Arduino-STM32-Dev/Arduino-Intro/Image_and_video/Buzzer_sound.jpg

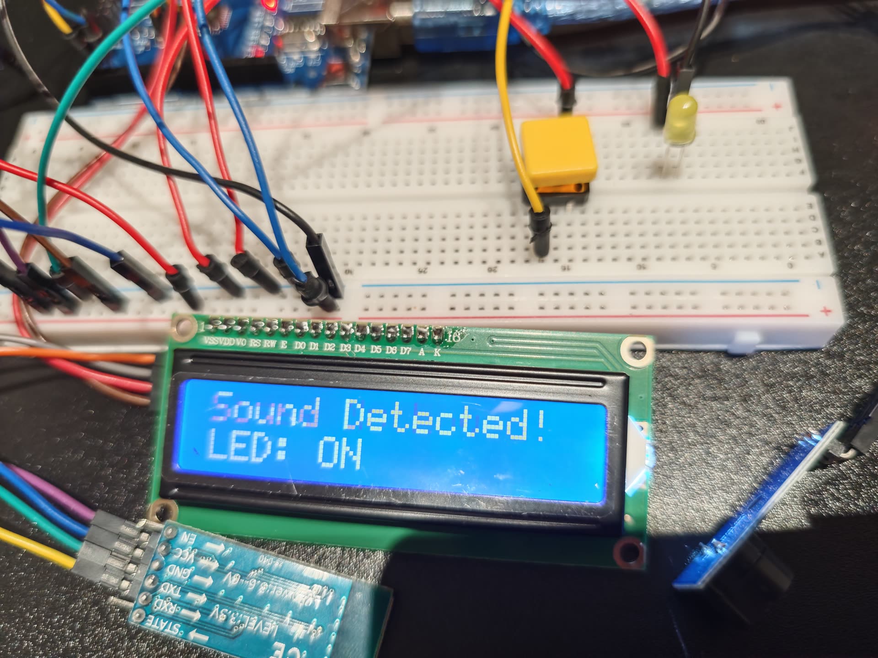
Image_and_video/Buzzer_sound.jpg
