Arduino-STM32-Dev/Arduino-Intro/(commit log)

2026-09-28 docs: 完整项目文档、接线指南与踩坑记录
    - README.md：项目简介、核心功能、硬件清单、引脚接线表、
    手机蓝牙指令表、软件架构解析、调试踩坑记录、未来计划
    - docs/WIRING.md：接线详解、I2C 地址扫描、面包板布局、上电自检清单
    - docs/COMMANDS.md：蓝牙指令协议完整参考与扩展建议
    - docs/TROUBLESHOOTING.md：11 类真实踩坑的现象/原因/解决/原理
    - docs/ROADMAP.md：五个学习阶段的能力跃迁记录
    - docs/LIBRARIES.md：依赖库版本、API 与许可证说明
    - LICENSE (MIT)、.gitignore、.gitattributes
2026-09-28 refactor: 统一目录结构，5 个 sketch 全部归入 firmware/
    按学习顺序排列：
    led_running_on_off -> 阶段1 外部 LED 闪烁 + 串口打印
    screen_words -> 阶段2 LCD1602 并行接线（含损坏行，见 TROUBLESHOOTING #11）
    LCD_show_words -> 阶段3 升级为 I2C 接线
    use_button_control_led -> 阶段4 按键 + 蓝牙控灯
    temp_monitor -> 阶段5 最终完整版（含 DHT11 温湿度）
    Git 识别为纯重命名（内容未改动），历史完整保留。
2026-09-28 docs: 修正内部锚点与相对路径链接
    - GitHub 锚点生成会剥离下划线，screen_words -> screenwords，
    修正 TROUBLESHOOTING 目录与 ROADMAP 的交叉引用
    - LIBRARIES.md 中两个 license 链接补上 ../libraries/ 前缀
2026-09-29 feat: complete integration of bluetooth, DHT11, light, sound and buzzer
    新增两个 sketch，完成从环境光控制到声光反馈的系统级集成：
    - firmware/Intelligent_LED/ 光敏模块(D4)接入，环境过暗自动开灯、变亮自动关灯
    - firmware/Buzzer_module/ (最终完整版) 光敏(D4) + 声音(D5) + 蜂鸣器(D3)
    + DHT11(D7) + 双 LED(D8/D9) + 蓝牙 + LCD + 按键
    - 补全 DHT11 温湿度查询（T 指令），使最终固件与文档描述一致
    - 低电平触发蜂鸣器，含按键提示音 / 指令音 / 警报音
    - 双重冷却时间解决蜂鸣器与声音传感器之间的自激振荡（1000ms + 600ms）
    文档更新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
    [Buzzer_module.ino, Intelligent_LED.ino]
